previmeteo/OSES-project/station-controller/hardware/bill-of-materials.txt

Open Source Environmental Sensors (OSES) project prototype / bill of materials :

# Modules : 

- AM2302 Wired temperature and humidity sensor (Aosong)
- BMP085 Barometric Pressure Sensor Breakout board (Sparkfun)
- Ultimate GPS Breakout board, version 3 (Adafruit)
- GPRSbee GSM/GPRS module (www.gprsbee.com)

# ICs :

- MCP73861 Li-Ion/Li-Po charge management controller (Microchip)
- NCP4625 Low Dropout Regulator (ON semiconductor)
- ATMEGA328 DIP microcontroller (Atmel)
- AP2161WG-7 USB switch (Diodes, Inc. / Zetex)
- PCF8563 Real-time clock/calendar (NXP)
- 24LC1025 1024K TWI Serial EEPROM (Microchip)

The MCP73861 (SOIC CMS package) can be soldered on a SOIC16 - DIL16 adapter.
The NCP4625 (SOT23 package) and the AP2161WG-7 (SOT25 package) ICs can be soldered on a SOT23 - DIL6 adapter.

# other components :

- resistors : 1 x 1.6K, 3 x 10K, 1 x 22K, 1 x 47K, 1 x 560K, 1 x 1M
- capacitors : 1 x 10pF, 2 x 22pF, 4 x 100nF, 2 x 1uF, 1 x 4.7uF
- crystals : 1 x 32.768Khz, 1 x 8MHz 
- leds : 2 x
- switches : 2 x SPST, 1 x push button
- connectors : 2 x 2 pins JST connectors

# battery

- 3.7V 2000mAh (or more) Li-Ion battery

# solar panel

- 1W (or more) solar panel with maximum open-circuit voltage of 10 V

The ATMEGA328 must have been programmed, at first, with the Arduino Pro Mini 3.3V / 8MHz bootloader. 

A 3.3V FTDI cable (or an equivalent device) is recommended to upload the sketches to the ATMEGA328.
