previmeteo/OSES-project/station-controller/hardware/schematics.pdf

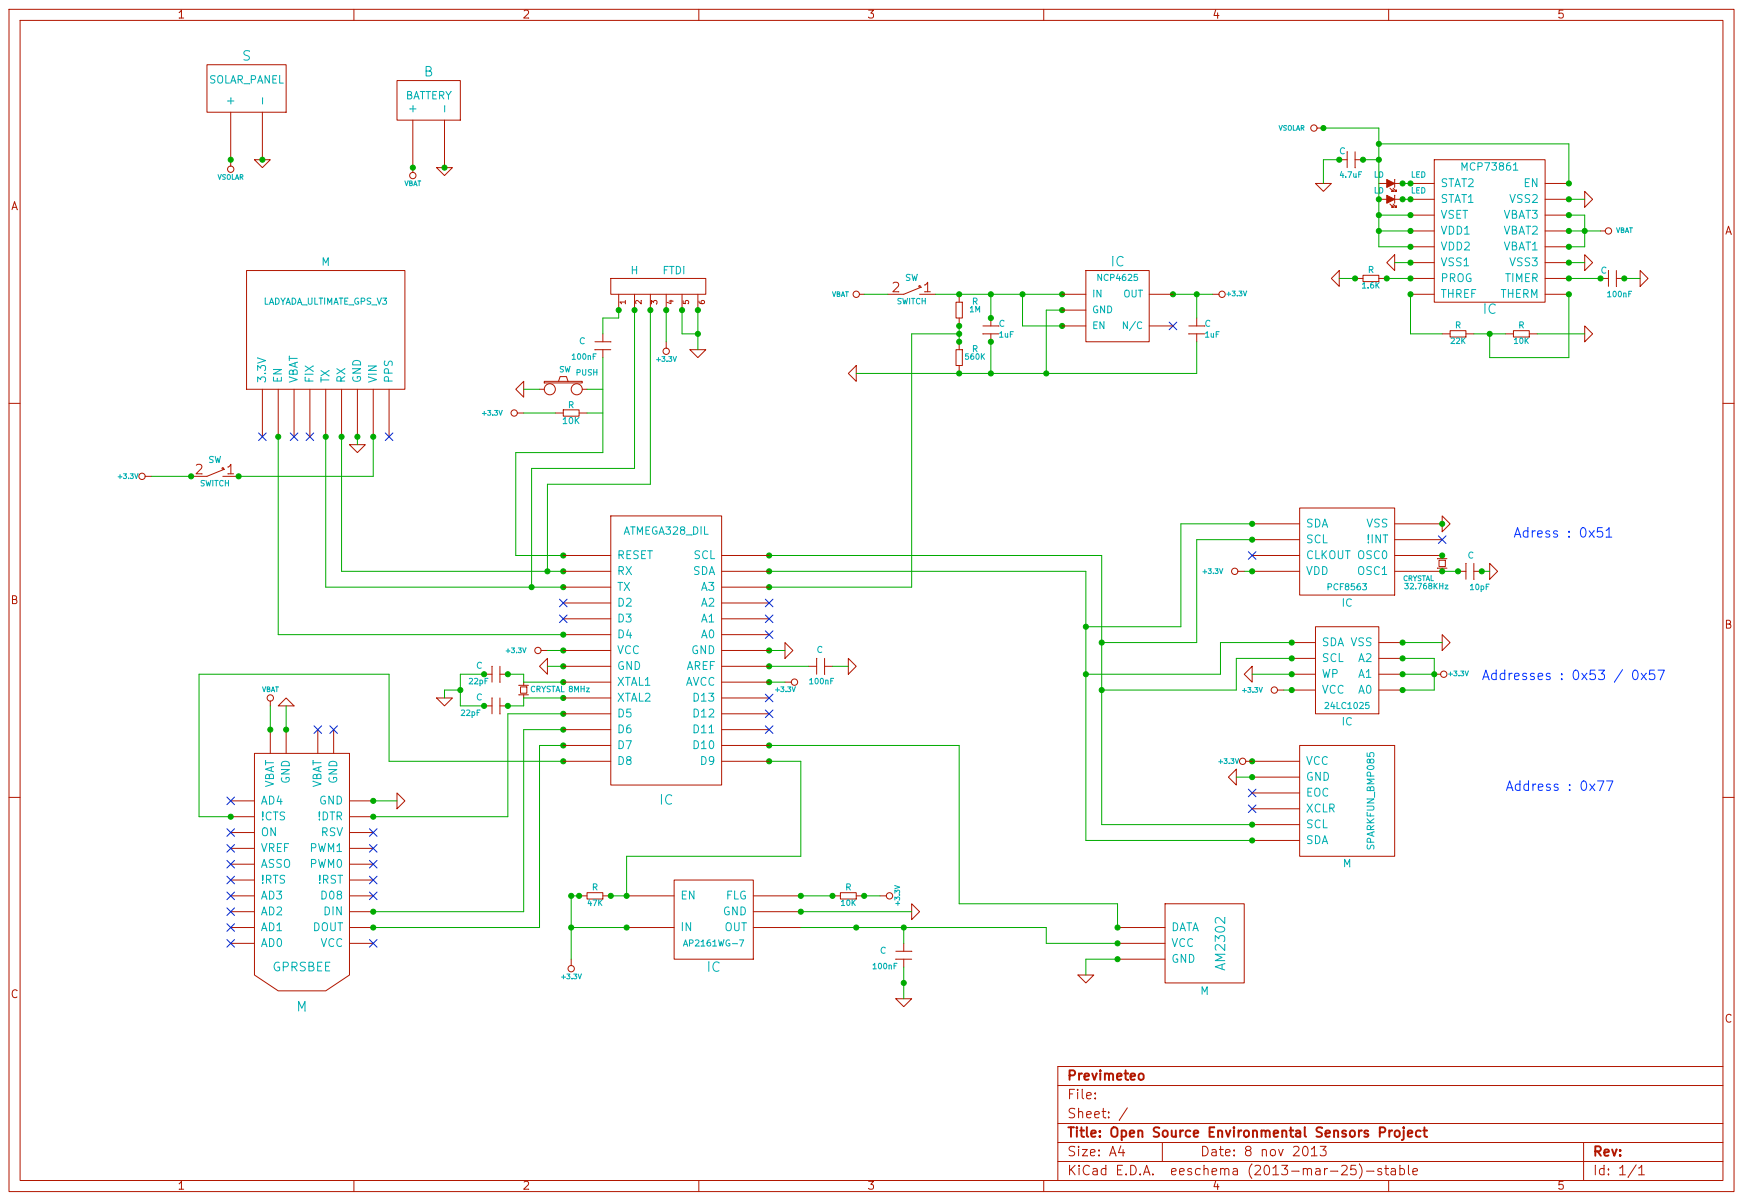
[picture p1: page 1]
